alihelkhatib/OpenRef/docs/adr/README.md

# Architecture Decision Records

Architecture Decision Records capture project decisions that should remain
traceable as prototypes evolve.

| ADR | Decision |
|---|---|
| [ADR-0001](ADR-0001-communication-topology-options.md) | Communication topology options. |
| [ADR-0002](ADR-0002-us-market-scope.md) | U.S. market scope. |
| [ADR-0003](ADR-0003-coordinated-distributed-topology.md) | Coordinated distributed topology. |
| [ADR-0004](ADR-0004-prototype-0-radio-platform.md) | FG23-DK2600A as lead Prototype 0 radio platform. |
| [ADR-0005](ADR-0005-esp32-wroom-role.md) | ESP32-WROOM role and why it is not the lead radio platform. |
