alihelkhatib/OpenRef/docs/power/replaceable-battery-architecture.md

# Replaceable Battery Architecture

**Document ID:** OR-PWR-002  
**Revision:** 0.1  
**Status:** Functional requirements and trade space

## Product Intent

The primary battery shall be field replaceable without tools and without opening the sealed electronics enclosure.

## Candidate Forms

- proprietary protected rechargeable pack;
- standardized cylindrical rechargeable cell in a sealed carrier;
- removable pouch-based pack;
- external clip-on battery module.

## Required Features

The battery system shall provide:

- reverse-insertion protection;
- short-circuit protection;
- overcurrent protection;
- overcharge and overdischarge protection;
- temperature monitoring;
- secure mechanical retention;
- sealing at the wearable interface;
- clear orientation;
- wear-resistant contacts;
- pack identification or compatibility checking where justified.

## Mechanical Principles

- retention shall not rely solely on friction;
- release shall require an intentional action;
- impact shall not eject the pack;
- battery replacement shall be possible with wet hands;
- the latch shall tolerate repeated use and contamination;
- contacts shall make before the enclosure is fully load-bearing where practical.

## Charging Model

The preferred operational workflow is:

- removable packs charged in a multi-bay charger;
- spare charged packs available during tournaments;
- no need to charge the wearable body during normal use;
- optional service charging only if it does not compromise sealing or safety.

## Architecture Gate

Battery form shall not be finalized until:

- load profile exists;
- minimum cell capacity is known;
- enclosure volume is estimated;
- thermal performance is modeled;
- charging logistics for six or more users are demonstrated.
