alihelkhatib/OpenRef/docs/architecture/interfaces.md

# External Interface Inventory

**Status:** Draft v0.1

Interfaces requiring later specifications:

- headset
- battery
- charging
- user controls
- status outputs
- wireless crew communication
- local configuration
- diagnostics
- firmware update and recovery
- mechanical mounting
- enclosure boundary

No connector, protocol, frequency band, or chipset is selected here.
