alihelkhatib/OpenRef/docs/standards/ENG-002-requirements-standard.md

# ENG-002: Requirements Standard

**Status:** Draft

Each requirement shall have a unique ID, title, singular verifiable statement, rationale, priority, verification method, traceability, and status.

Priority values: Critical, High, Medium, Low.

Verification methods: Inspection, Analysis, Demonstration, Test.
