alihelkhatib/OpenRef/docs/standards/ENG-006-electronics-standard.md

# ENG-006: Electronics Standard

**Status:** Draft

Use consistent reference designators, descriptive net names, explicit power rails, documented pinouts, orientation markings, test points, design-rule checks, and controlled library components.
