alihelkhatib/OpenRef/docs/requirements/srs.md

# OpenRef System Requirements Specification (Draft v0.1)

> **Status:** Working Draft

> **Purpose:** Foundational requirements captured during initial product
> definition.

# 1. Communication

- **COM-001** The system shall support continuous, full-duplex voice
  communication between six simultaneously connected match officials.

- **COM-002** The system shall provide end-to-end voice latency low
  enough to permit natural conversation without perceptible delay.

- **COM-003** The system shall permit any connected official to begin
  speaking at any time without requesting permission.

- **COM-004** The system shall automatically recover from temporary
  communication interruptions without user intervention.

- **COM-005** A match crew shall be able to establish communication
  using a simple, repeatable process requiring minimal interaction.

- **COM-006** The system shall automatically reconnect previous crew
  members when it can do so safely and without ambiguity.

- **COM-007** The system shall prevent communication between separate
  match crews unless explicitly authorized.

- **COM-008** The system shall clearly indicate whether a user is
  connected to the intended crew.

- **COM-009** A new official shall be able to join an active crew
  without disrupting existing communication.

- **COM-010** The system shall notify the crew of sustained member
  disconnections without interrupting communication.

- **COM-011** The system shall prioritize uninterrupted communication
  during transient RF degradation.

- **COM-012** The system shall distinguish transient interference from
  sustained disconnections before notifying users.

- **COM-013** The system shall prioritize intelligible speech over
  maximum fidelity.

- **COM-014** The system shall support overlapping speech.

- **COM-015** Crew capacity shall be configurable without hardware
  redesign.

- **COM-016** Active communication shall take priority over
  non-essential functions.

- **COM-017** The system shall clearly indicate match readiness.

- **COM-018** Officials shall automatically rejoin an active crew
  following unintentional interruption when safe.

- **COM-019** Voice communication shall become immediately available
  after successful connection.

- **COM-020** Continuous communication shall not require periodic user
  interaction.

- **COM-021** The system shall degrade gracefully before declaring
  communication unavailable.

- **COM-022** The system shall preserve active crew integrity.

- **COM-023** Communication shall continue until intentionally ended by
  the crew.

# 2. Audio

- **AUD-001** Prioritize speech intelligibility.

- **AUD-002** Reduce environmental noise while preserving speech.

- **AUD-003** Maintain intelligibility in wind.

- **AUD-004** Normalize reasonable speaking-volume differences.

- **AUD-005** Require no microphone gain adjustments during matches.

- **AUD-006** Provide a consistent listening experience.

- **AUD-007** Prevent objectionable echo and feedback.

- **AUD-008** Minimize listener fatigue.

- **AUD-009** Recover cleanly from brief audio corruption.

- **AUD-010** Allow independent user volume control.

- **AUD-011** Prevent accidental reduction below a safe listening level.

- **AUD-012** Avoid clipping the beginning of speech.

- **AUD-013** Preserve the end of speech naturally.

- **AUD-014** Support natural conversational speaking.

- **AUD-015** Preferentially capture the official's speech.

- **AUD-016** Maintain consistent perceived audio quality.

- **AUD-017** Operate normally in rain.

- **AUD-018** Resist sweat-induced degradation.

- **AUD-019** Recover automatically after temporary moisture exposure.

- **AUD-020** Provide configurable sidetone.

- **AUD-021** Select intelligent default sidetone behavior.

- **AUD-022** Minimize audible processing artifacts.

- **AUD-023** Prevent distracting background-noise pumping.

- **AUD-024** Preserve natural speaker distinction.

- **AUD-025** Eliminate startup pops and clicks.

- **AUD-026** Eliminate shutdown artifacts.

- **AUD-027** Prevent audible electronic noise.

- **AUD-028** Prioritize speech comprehension over fidelity.

# 3. Reliability

- **REL-001** Operate continuously throughout expected match duration.

- **REL-002** Recover automatically from recoverable faults.

- **REL-003** Fail gracefully whenever practical.

- **REL-004** Behave predictably under abnormal conditions.

- **REL-005** Continuously monitor operational health.

- **REL-006** Return to the safest operational state preserving
  communication.

- **REL-007** Never allow non-essential functions to compromise voice.

- **REL-008** Require no firmware updates or internet during normal
  operation.

- **REL-009** Maintain stable long-term performance.

- **REL-010** Allow field recovery from common problems.

- **REL-011** Defer non-critical fault notifications until appropriate.

- **REL-012** Immediately report faults threatening communication.

- **REL-013** Start in a predictable state.

- **REL-014** Recover predictably after restart.

- **REL-015** Preserve configuration.

- **REL-016** Protect critical settings from accidental modification.

- **REL-017** Maintain reliability across specified environments.

- **REL-018** Ensure compatibility among approved OpenRef components.

- **REL-019** Preserve service continuity when optional accessories
  fail.

- **REL-020** Inspire operational confidence.

# 4. Power

- **PWR-001** Operate for a full expected match day.

- **PWR-002** Report remaining operating time accurately.

- **PWR-003** Warn users of low battery in advance.

- **PWR-004** Escalate notifications as battery becomes critical.

- **PWR-005** Preserve communication under low power.

- **PWR-006** Perform orderly shutdown if unavoidable.

- **PWR-007** Clearly indicate charging status.

- **PWR-008** Monitor battery health.

- **PWR-009** Protect against abnormal charging.

- **PWR-010** Charge safely across environmental conditions.

- **PWR-011** Use a user-replaceable battery.

- **PWR-012** Preserve settings after battery replacement.

- **PWR-013** Protect against incorrect battery installation.

- **PWR-014** Verify battery compatibility.

# 5. Durability

- **DUR-001** Professional-duty design.

- **DUR-002** Survive normal drops.

- **DUR-003** Operate in rain.

- **DUR-004** Resist sweat.

- **DUR-005** Resist mud, dust, and dirt.

- **DUR-006** Tolerate repeated transportation.

- **DUR-007** Durable connectors.

- **DUR-008** Resist cosmetic and functional wear.

- **DUR-009** Remain securely attached during officiating.

- **DUR-010** Recover after environmental exposure.

# 6. Ergonomics

- **ERG-001** Comfortable for extended wear.

- **ERG-002** Minimize cognitive load.

- **ERG-003** Operable with gloves.

- **ERG-004** Operable with one hand.

- **ERG-005** Operable without looking.

- **ERG-006** Easy to handle with wet hands.

- **ERG-007** Stable on standard uniforms.

- **ERG-008** Minimize unnecessary bulk.

- **ERG-009** Support left- and right-handed users.

- **ERG-010** Minimize physical fatigue.

# 7. User Interface

- **UI-001** Easy to learn.

- **UI-002** Consistent interactions.

- **UI-003** Immediate feedback.

- **UI-004** Prevent common user errors.

- **UI-005** Enable easy recovery from mistakes.

- **UI-006** Minimize interaction steps.

- **UI-007** Clearly communicate system status.

- **UI-008** Safely infer user intent.

- **UI-009** Minimize match distraction.

- **UI-010** Hide advanced functionality until needed.

## Remaining sections planned

- Connectivity & Pairing

- Serviceability

- Security

- Firmware

- Mechanical Design

- Regulatory & Compliance

- Manufacturing

- Verification & Validation
