alihelkhatib/OpenRef/docs/adr/ADR-0006-prototype-audio-processor-platform.md

# ADR-0006: Prototype Audio Processor Platform

**Status:** Accepted for bench prototype; production processor not selected  
**Date:** 2026-08-14

## Context

The EFR32FG23 hardware benchmark required about 23.04 ms for one LC3 encode and
five LC3 decodes that must complete every 10 ms. Radio scheduling remained
healthy, but the codec workload alone exceeded the deadline. OpenRef therefore
needs a separate audio processor for codec, mixing, microphone capture, and
headphone playback.

## Decision

Use the **MIMXRT595-EVK** for the next audio bench prototype. It combines a
200 MHz Cortex-M33, a 200 MHz Cadence Fusion F1 DSP, 5 MB internal SRAM, dual
digital microphones, an audio codec with headphone output, expansion
interfaces, and onboard debug support.

Official platform source:
<https://www.nxp.com/design/design-center/development-boards-and-designs/i-mx-evaluation-and-development-boards/i-mx-rt595-evaluation-kit%3AMIMXRT595-EVK>

This selects a validation platform, not the production MCU. Production
selection still requires measured timing, power, package/layout, toolchain,
cost, lifecycle, and supply evidence.

## Vendor correspondence

The following correspondence informs the candidate list but is not measured
promotion evidence:

- On 2026-08-17, an Ambiq field applications engineer assessed Apollo510 as a
  plausible fit, expecting sustained 250 MHz high-performance operation for a
  workload he estimated near 200 MIPS when six-channel mixing, echo
  cancellation, and noise suppression are included. He supplied a preliminary
  processor estimate of 11.75 mW (about 6.53 mA at the assumed rail). Those
  figures are vendor estimates for a broader workload, not OpenRef benchmark
  measurements. Ambiq subsequently reported that it had no loan board
  available; a local representative requested a project discussion.
- On 2026-08-20, Analog Devices Processor Applications Support recommended
  ADSP-BF706 or ADSP-BF707 as the most suitable members of its current
  Blackfin+ family for the supplied requirements. Evaluation-board selection
  and access remain under discussion.
- The NXP MIMXRT595-EVK and XMOS XU316 requests sent on 2026-08-14 have no
  vendor response in the referenced mailbox threads as of 2026-08-20.

Mail correspondence is mutable and access-controlled, so release decisions
must cite a reviewed engineering record containing the relevant vendor date,
role, assumptions, and any permitted quotation or attachment. It cannot
replace the processor-neutral paced benchmark, current capture, or lifecycle
and commercial review.

## Alternative

The NUCLEO-H563ZI is the fallback. STM32H563 provides a 250 MHz Cortex-M33,
640 KB RAM, 2 MB flash, SPI, and I2S, but its Nucleo board needs external
microphone and headphone hardware before full-chain testing.

Official sources:

- <https://www.st.com/en/microcontrollers-microprocessors/stm32h563zi.html>
- <https://www.st.com/en/evaluation-tools/nucleo-h563zi.html>

The single-FG23 alternative is rejected for six-participant audio by direct
timing evidence. The FG23 remains the radio/network processor.

## Exit Tests

The RT595 prototype is accepted only after it demonstrates:

1. one LC3 encode plus five decodes, mixing, and audio I/O inside 8 ms of each
   10 ms interval;
2. bounded stack and static memory with at least 20% capacity margin;
3. continuous microphone-to-headphone and encoded loopback;
4. the fixed 98-byte link at 8 MHz or faster with CRC, sequence-gap, reset,
   and overflow fault injection;
5. no stale playback and correct PLC for either missing half-frame;
6. measured active and sleep current for the power trade study.
