alihelkhatib/OpenRef/docs/program/decision-log.md

# Product Decision Log

**Document ID:** OR-PGM-002  
**Revision:** 0.1

| ID | Date | Decision | Status |
|---|---|---|---|
| DEC-001 | 2026-07-29 | Version 1 market is the United States. | Accepted |
| DEC-002 | 2026-07-29 | Pennsylvania is the initial field-validation environment. | Accepted |
| DEC-003 | 2026-07-29 | Core communication shall not depend on a phone, internet, cloud service, cellular service, or subscription. | Accepted |
| DEC-004 | 2026-07-29 | Baseline crew size is six simultaneous full-duplex users. | Accepted |
| DEC-005 | 2026-07-29 | The primary battery is user-replaceable. | Accepted |
| DEC-006 | 2026-07-29 | Coordinated distributed topology is the current baseline for prototyping. | Proposed |
| DEC-007 | 2026-08-14 | The FG23 remains the radio processor; MIMXRT595-EVK is the separate audio validation platform. | Accepted for prototype |
