alihelkhatib/OpenRef/docs/compliance/regulatory-sources.md

# Regulatory Sources

**Status:** Informative  
**Last reviewed:** 2026-07-29

Primary sources used for the preliminary U.S. plan:

- 47 CFR Part 15 — Radio Frequency Devices  
  https://www.ecfr.gov/current/title-47/chapter-I/subchapter-A/part-15
- 47 CFR Part 15 Subpart C — Intentional Radiators  
  https://www.ecfr.gov/current/title-47/chapter-I/subchapter-A/part-15/subpart-C
- 47 CFR § 15.247 — 902–928 MHz, 2400–2483.5 MHz, and 5725–5850 MHz  
  https://www.ecfr.gov/current/title-47/chapter-I/subchapter-A/part-15/subpart-C/subject-group-ECFR2f2e5828339709e/section-15.247
- 47 CFR § 15.203 — Antenna requirement  
  https://www.ecfr.gov/current/title-47/chapter-I/subchapter-A/part-15/subpart-C
- OSHA battery manufacturing and lithium-ion safety resources  
  https://www.osha.gov/battery-manufacturing

These sources shall be reviewed again when the radio, antenna, battery, charger, manufacturing location, and commercialization model are selected.
