alihelkhatib/OpenRef/docs/interfaces/interface-framework.md

# Interface Control Framework

**Document ID:** OR-ICD-000  
**Revision:** 0.1  
**Status:** Draft

Each interface-control document shall define:

1. Interface purpose and ownership
2. Participating elements
3. Mechanical characteristics
4. Electrical characteristics
5. Information exchanged
6. Timing and performance
7. Initialization and shutdown
8. Normal behavior
9. Fault behavior
10. Safety and protection
11. Security
12. Versioning and compatibility
13. Verification

## Planned ICDs

- OR-ICD-001 Headset Interface
- OR-ICD-002 Battery Interface
- OR-ICD-003 Charging Interface
- OR-ICD-004 User Controls
- OR-ICD-005 Status Indications
- OR-ICD-006 Wireless Crew Interface
- OR-ICD-007 Configuration and Diagnostics
- OR-ICD-008 Firmware Update and Recovery
- OR-ICD-009 Mechanical Mounting
