alihelkhatib/OpenRef/docs/standards/ENG-003-naming-standard.md

# ENG-003: Naming Standard

**Status:** Draft

Use `OR` for controlled OpenRef assemblies and documents. Use conventional reference designators and lowercase snake_case for firmware modules. Use lowercase kebab-case filenames.
