alihelkhatib/OpenRef/docs/standards/ENG-005-cad-standard.md

# ENG-005: CAD Standard

**Status:** Draft

Controlled parts shall define part number, revision, material, finish, critical dimensions, tolerances, coordinate system, and mating interfaces. Release neutral manufacturing formats with controlled revisions.
