alihelkhatib/OpenRef/docs/architecture/context.md

# OpenRef System Context

**Status:** Draft v0.1

External actors and systems include match officials, equipment managers, maintainers, batteries, charging sources, approved headsets, local service tools, nearby crews, unrelated RF systems, and the physical environment.

Core communication does not depend on internet access, cloud services, accounts, subscriptions, cellular service, a phone, or venue infrastructure.
