alihelkhatib/OpenRef/docs/references/radio-platform-sources.md

# Radio Platform Sources

**Document ID:** OR-REF-001  
**Revision:** 0.2  
**Accessed:** 2026-07-29

Primary sources consulted for ADR-0004:

1. Silicon Labs — EFR32FG23 product and development-kit listings.
2. Silicon Labs — FG23-DK2600A 868–915 MHz +14 dBm development-kit information.
3. Silicon Labs — EFR32xG23 868–915 MHz Pro Kit information.
4. DigiKey — FG23-DK2600A active product listing and fulfillment information.
5. Texas Instruments — LP-CC1352P7 development-kit page.
6. Texas Instruments — CC1352P7 product page and data sheet.

## Correct Variant Record

- `LP-CC1352P7-1`: 868/915 MHz plus 2.4 GHz.
- `LP-CC1352P7-4`: 433 MHz plus 2.4 GHz.
- `FG23-DK2600A`: 868–915 MHz +14 dBm development kit.

## Source-Control Rule

Do not copy vendor example code into OpenRef without recording:

- exact SDK release;
- source file;
- applicable license;
- modifications;
- binary dependencies.

## Procurement Rule

Availability, pricing, board revision, lifecycle status, and exact frequency variant shall be rechecked immediately before purchase.
