alihelkhatib/OpenRef/tmp/pdfs/fgm230s-page43.png

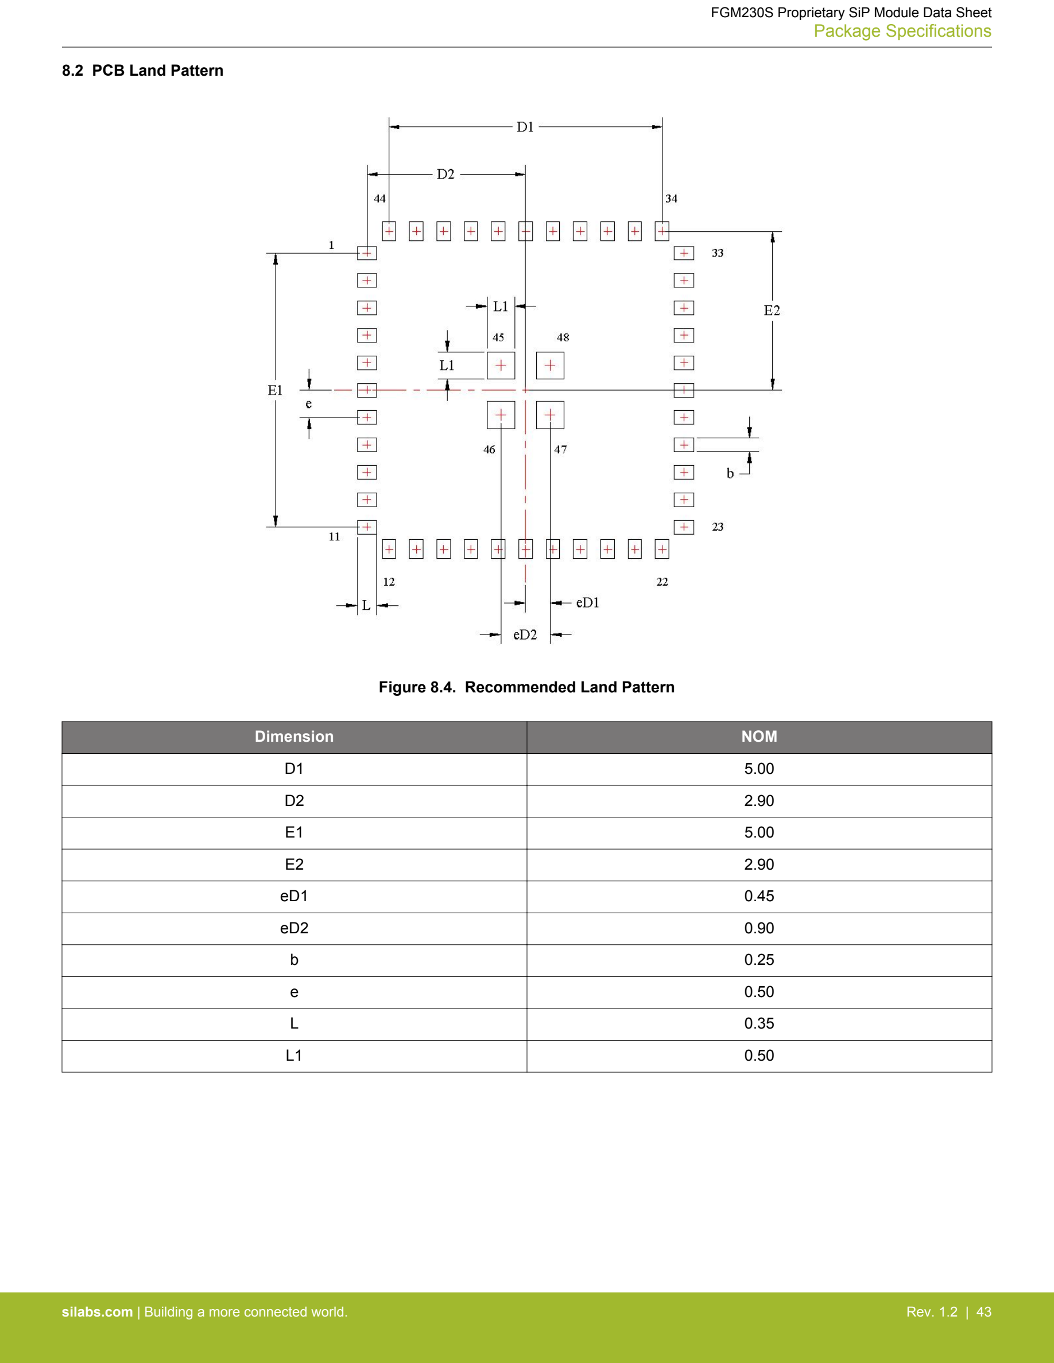
tmp/pdfs/fgm230s-page43.png
