alihelkhatib/OpenRef/tmp/pdfs/fgm230sb-footprint-preview.png

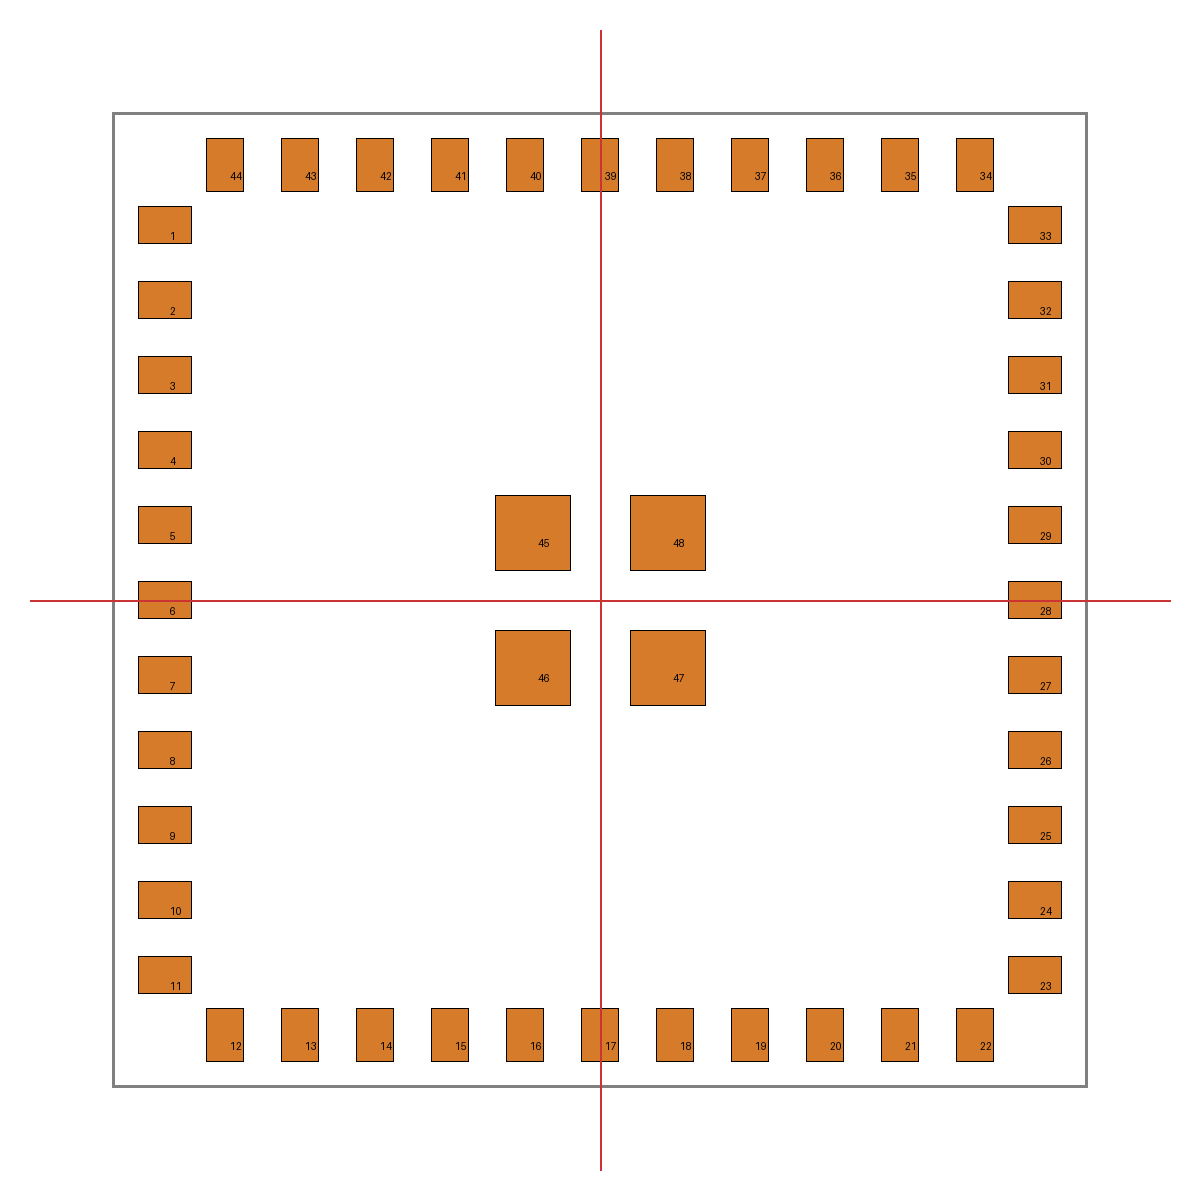
tmp/pdfs/fgm230sb-footprint-preview.png
