alihelkhatib/OpenRef/docs/manufacturing/README.md

# Manufacturing

Manufacturing records must preserve unit traceability, test limits, measured
results, provisioning disposition, firmware identity, and fixture calibration
without exposing private credentials or captured audio.

`production-test-sequence.md` defines the fixture-independent electrical,
audio, RF, recovery, security, programming, and evidence sequence for
Prototype 1.
