alihelkhatib/OpenRef/docs/testing/README.md

# OpenRef Testing

This directory contains verification strategy, test plans, test case templates,
and early Prototype 0 evidence.

## Key Documents

| Document | Purpose |
|---|---|
| [verification-strategy.md](verification-strategy.md) | Overall verification approach. |
| [architecture-verification-matrix.md](architecture-verification-matrix.md) | Links architecture subjects to requirements and methods. |
| [architecture-verification-evidence.md](architecture-verification-evidence.md) | Defines hash-bound evidence accepted by the MVP readiness audit. |
| [prototype-0-test-plan.md](prototype-0-test-plan.md) | Six-node network feasibility test plan. |
| [prototype-0-entry-tests.md](prototype-0-entry-tests.md) | Board-level tests before full protocol implementation. |
| [prototype-0-simulator-screening.md](prototype-0-simulator-screening.md) | Simulator sweep method and initial screening result. |
| [test-case-template.md](test-case-template.md) | Template for controlled test procedures. |
