alihelkhatib/OpenRef/firmware/prototype0/fg23/results/README.md

# FG23 Prototype 0 Results

Store local raw logs and measurement exports here during board testing.

Generated `.csv`, `.log`, and `.json` files are ignored by Git. Commit concise
analysis notes only after checking they do not include local serial numbers or
machine-specific paths.
