alihelkhatib/OpenRef/firmware/prototype0/fg23/20260807-openref-overlay-build-result.md

# 20260807 OpenRef Overlay Build Result

**Date:** 2026-08-07  
**Status:** Pass

## Purpose

Verify that the first OpenRef-owned packet helper and packet-pair scaffold
compile inside the generated Silicon Labs `rail_soc_railtest` CMake/GCC project.

## Overlay

Installed with:

```powershell
powershell -ExecutionPolicy Bypass -File tools\install_openref_fg23_overlay.ps1
```

The installer copies repository-owned files into the local Simplicity workspace:

```text
C:\Users\aliel\SimplicityStudio\v6_workspace\rail_soc_railtest\openref
```

and creates:

```text
C:\Users\aliel\SimplicityStudio\v6_workspace\rail_soc_railtest\cmake_gcc\rail_soc_railtest_project.cmake
```

The generated project already includes that optional CMake file, so this avoids
editing generated Silicon Labs CMake content directly.

## Build Command

```powershell
$env:PATH='C:\Users\aliel\.silabs\slt\installs\conan\p\cmakefa35ab0687064\p\bin;C:\Users\aliel\.silabs\slt\installs\conan\p\ninja1a38fc85adcf7\p;' + $env:PATH
cmake --workflow --preset project
```

## Result

The project configured and linked successfully:

```text
Building openref_proto0_packet.c.obj
Building openref_packet_pair.c.obj
Linking C executable base\rail_soc_railtest.out
```

## Notes

This proves the OpenRef packet helper/scaffold compiles with the Silicon Labs
ARM GCC toolchain. It does not yet replace RAILtest runtime behavior; the
OpenRef packet-pair TX/RX app entry point and RAIL adapter still need to be
implemented before flashing custom E0-02 firmware.
