alihelkhatib/OpenRef/firmware/prototype0/fg23/templates/e0-01-toolchain-result.md

# E0-01 Toolchain Reproduction Result

**Date:** TBD  
**Tester:** TBD  
**Status:** Draft

## Hardware

| Item | Value |
|---|---|
| Board 1 identifier | Local note only |
| Board 2 identifier | Local note only |
| USB cables | TBD |
| Host computer | TBD |

## Toolchain

| Item | Value |
|---|---|
| Simplicity Studio version | TBD |
| Gecko SDK version | TBD |
| Compiler/toolchain version | TBD |
| Vendor example project | TBD |
| Radio/PHY profile | TBD |

## Procedure Evidence

- Build log path: TBD
- Flash/programming log path: TBD
- Board 1 serial capture path: TBD
- Board 2 serial capture path: TBD
- Board detection screenshot/export path: TBD

## Result

- [ ] Vendor example built from a clean checkout/setup.
- [ ] Board 1 flashed successfully.
- [ ] Board 2 flashed successfully.
- [ ] Board 1 serial output captured.
- [ ] Board 2 serial output captured.
- [ ] Exact SDK/example source recorded in `vendor-notes.md`.

## Deviations

TBD

## Decision

- [ ] Proceed to E0-02.
- [ ] Blocked pending corrective action.
