alihelkhatib/OpenRef/docs/standards/ENG-008-testing-standard.md

# ENG-008: Testing Standard

**Status:** Draft

Each test shall define an ID, purpose, linked requirements, equipment, configuration, procedure, expected result, pass/fail criteria, evidence, tester, date, and applicable hardware and firmware revisions.
