alihelkhatib/OpenRef/docs/safety/preliminary-hazard-analysis.md

# Preliminary Hazard Analysis

**Document ID:** OR-SAF-001  
**Revision:** 0.1  
**Status:** Draft

## Risk Scale

Severity:

- S1 negligible
- S2 minor
- S3 serious
- S4 critical

Probability:

- P1 improbable
- P2 remote
- P3 occasional
- P4 probable

Initial risk is recorded before mitigation.

| ID | Hazardous Condition | Effect | Initial Risk | Required Controls |
|---|---|---|---|---|
| HAZ-001 | Battery internal short or thermal event | Burn, fire, property damage | S4/P2 | Protected cells or pack, thermal limits, current protection, mechanical protection, qualified charging, fault containment |
| HAZ-002 | Excessive earpiece level | Hearing discomfort or injury; missed environmental cues | S3/P2 | Output limits, safe defaults, controlled gain range, verification with approved accessories |
| HAZ-003 | Incorrect crew association | Confidentiality loss; operational confusion | S3/P2 | Authenticated crew formation, explicit confirmation, nearby-crew isolation tests |
| HAZ-004 | Total communication loss without clear indication | Missed critical officiating information | S3/P3 | Link monitoring, unmistakable degradation indication, automatic recovery, documented fallback |
| HAZ-005 | One transmitting fault disrupts entire crew | Loss of communication | S3/P2 | Fault containment, admission control, watchdogs, malformed-traffic rejection |
| HAZ-006 | Stuck or saturated microphone path | Crew audio masked or unusable | S3/P3 | Level monitoring, clipping control, fault isolation, optional administrative recovery |
| HAZ-007 | Water ingress creates electrical fault | Device loss, heating, erratic operation | S3/P2 | Sealing, drainage where appropriate, conformal protection as justified, ingress verification |
| HAZ-008 | Battery detaches during play | Loss of communication; dropped object | S2/P3 | Positive retention, secondary geometry, drop and snag testing |
| HAZ-009 | Cable or headset snags | Distraction or minor injury | S2/P3 | Breakaway/retention trade study, routing guidance, strain relief |
| HAZ-010 | Corrupted firmware update | Inoperable unit | S2/P2 | Signed images, atomic update, rollback or recovery mode |
| HAZ-011 | Counterfeit or incompatible battery/accessory | Damage or unsafe behavior | S3/P2 | Mechanical keying, electrical protection, published compatibility limits |
| HAZ-012 | Ambiguous warning indication | User takes incorrect action | S2/P3 | Consistent semantics, human-factors validation |
| HAZ-013 | Surface temperature becomes excessive | Discomfort or burn | S3/P2 | Thermal design limits, monitoring, shutdown, worst-case testing |
| HAZ-014 | Charging contact contamination or short | Heating, charging failure | S3/P2 | Protected contacts, current limiting, contamination testing |
| HAZ-015 | Unauthorized firmware or configuration | Privacy loss or unsafe behavior | S3/P2 | Authenticated updates, protected production keys, controlled service mode |

## Safety Process

Every architecture and detailed-design review shall:

- evaluate whether new hazards were introduced;
- link mitigations to requirements;
- define verification evidence;
- record residual risk;
- require product-owner approval for residual S4 risk.
