alihelkhatib/OpenRef/(list of files, drawings)

Other design files:
hardware/prototype1-wearable/schematic-connectivity.json
