alihelkhatib/OpenRef/firmware/prototype0/fg23/src/openref_network_fg23.h

#ifndef OPENREF_NETWORK_FG23_H
#define OPENREF_NETWORK_FG23_H

#ifdef __cplusplus
extern "C" {
#endif

void openref_network_fg23_init(void);
void openref_network_fg23_process(void);

#ifdef __cplusplus
}
#endif

#endif
