alihelkhatib/OpenRef/firmware/prototype0/fg23/src/openref_watchdog_fg23_sdk.h

#ifndef OPENREF_WATCHDOG_FG23_SDK_H
#define OPENREF_WATCHDOG_FG23_SDK_H

#include "openref_watchdog_fg23.h"

#ifdef __cplusplus
extern "C" {
#endif

openref_watchdog_fg23_hooks_t openref_watchdog_fg23_sdk_hooks(void);

#ifdef __cplusplus
}
#endif

#endif
