alihelkhatib/OpenRef/firmware/prototype0/fg23/src/openref_device_record_store_fg23.h

#ifndef OPENREF_DEVICE_RECORD_STORE_FG23_H
#define OPENREF_DEVICE_RECORD_STORE_FG23_H

#include "openref_config_store.h"

openref_config_backend_t openref_device_record_store_fg23_backend(void);

#endif
