alihelkhatib/OpenRef/firmware/prototype0/fg23/src/openref_lc3_benchmark.h

#ifndef OPENREF_LC3_BENCHMARK_H
#define OPENREF_LC3_BENCHMARK_H

#ifdef __cplusplus
extern "C" {
#endif

void openref_lc3_benchmark_init(void);
void openref_lc3_benchmark_process(void);

#ifdef __cplusplus
}
#endif

#endif
