alihelkhatib/OpenRef/firmware/prototype0/fg23/src/openref_secure_startup_fg23.h

#ifndef OPENREF_SECURE_STARTUP_FG23_H
#define OPENREF_SECURE_STARTUP_FG23_H

#include <stdbool.h>

#include "openref_secure_startup.h"

bool openref_secure_startup_fg23_init(openref_secure_startup_t *startup);

#endif
