alihelkhatib/OpenRef/firmware/audio_processor/targets/mimxrt595_evk/openref_rt595_update_crypto_test.c

#include "openref_rt595_update_crypto.h"
#include <assert.h>
#include <stdio.h>
#include <string.h>
typedef struct{bool ok;unsigned begins,updates,finishes,verifies;}fake_t;static bool b(void*c){((fake_t*)c)->begins++;return ((fake_t*)c)->ok;}static bool u(void*c,const uint8_t*d,uint32_t n){(void)d;(void)n;((fake_t*)c)->updates++;return ((fake_t*)c)->ok;}static bool f(void*c,uint8_t*d){memset(d,0x5a,32);((fake_t*)c)->finishes++;return ((fake_t*)c)->ok;}static bool v(void*c,const uint8_t p[64],const uint8_t h[32],const uint8_t s[64]){(void)p;(void)h;(void)s;((fake_t*)c)->verifies++;return ((fake_t*)c)->ok;}
int main(void){fake_t state={.ok=true};uint8_t id[8]={1},pk[64]={2},data[80]={0},signature[64]={3},digest[32];openref_rt595_update_crypto_t x;openref_rt595_update_crypto_driver_t d={b,u,f,v,&state};assert(openref_rt595_update_crypto_init(&x,d,id,pk));openref_update_crypto_t c=openref_rt595_update_crypto_callbacks(&x);assert(c.verify_signature(c.context,data,id,signature));uint8_t wrong[8]={2};assert(!c.verify_signature(c.context,data,wrong,signature)&&x.rejected_keys==1);assert(c.hash_begin(c.context)&&c.hash_update(c.context,data,80)&&c.hash_finish(c.context,digest));state.ok=false;assert(!c.hash_begin(c.context)&&x.failures==1);memset(pk,0,sizeof(pk));assert(!openref_rt595_update_crypto_init(&x,d,id,pk));puts("openref_rt595_update_crypto_test: PASS");return 0;}
