alihelkhatib/OpenRef/(commit log)

2026-07-29 docs: add systems engineering framework
2026-07-29 docs: define radio audio security and prototype architecture
2026-07-29 docs: select Prototype 0 radio platform
2026-07-29 docs: correct Prototype 0 radio platform selection
2026-07-29 feat: simulate drift loss queues and coordinator recovery
    [collision-trace.csv, nominal-trace.csv]
2026-07-29 docs: define OpenRef network protocol v1
    [coordinator-failure-trace.csv, drift-trace.csv]
2026-08-08 feat: add PCB development plan and support fixture details to hardware documentation
2026-08-08 feat: add product requirements and testing documentation for Prototype 0
2026-08-08 feat: add documentation for Prototype 0 and Prototype 1 support hardware, including requirements and readiness checklist
2026-08-08 Refactor simulator code for improved clarity and functionality
    - Introduced `VoiceConfig` and `CoordinatorConfig` dataclasses to encapsulate configuration parameters for voice nodes and coordinator protocol.
    - Updated `VoiceNode` and `CoordinatorProtocol` classes to utilize the new configuration dataclasses, enhancing readability and maintainability.
    - Enhanced `SharedMedium` class to support callback functionality on transmission completion.
    - Added a new `SweepResult` dataclass to facilitate the results of parameter sweeps, including feasibility checks based on delivery ratios and latency.
    - Implemented a sweeping mechanism in `sweep.py` to evaluate various configurations and output result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
    [collision-trace.csv, coordinator-failure-trace.csv, drift-trace.csv, nominal-trace.csv]
2026-08-08 Add unit tests for various railtest modules
    - Implement tests for bidirectional retention functionality in `test_railtest_bidirectional_retention.py`.
    - Create a test for capacity sweep help command in `test_railtest_capacity_sweep.py`.
    - Add fault probe help command test in `test_railtest_fault_probe.py`.
    - Introduce tests for openref autotx and packet run functionalities in `test_railtest_openref_autotx_rx.py` and `test_railtest_openref_packet_run.py`.
    - Implement packet run parsing tests in `test_railtest_packet_run.py`.
    - Add smoke tests for pair functionality in `test_railtest_pair_smoke.py`.
    - Create RSSI probe tests in `test_railtest_rssi_probe.py`.
    - Implement RX overflow recovery pr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
    [packet-pair-sample.csv]
2026-08-15 Implemented and verified the processor-neutral audio benchmark workflow. Changes: Retained the callback-only target port in [openref_audio_benchmark.h](C:/Users/aliel/.codex/worktrees/4d39/openref/fi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
    [fgm230sb-symbol-pins.csv, schematic-connectivity.json]
2026-09-04 feat: add fail-closed architecture readiness evidence
    [audit_mvp_readiness.py, run_firmware_native_tests.py]
2026-09-04 docs: refine Prototype 1 hardware readiness baseline
    [kicad.kicad_pcb, kicad.kicad_sch]
